bdureau/MotorTestStand/board images/teststand board.jpg

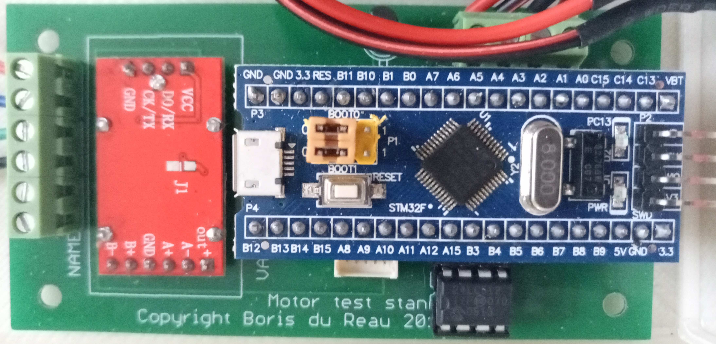
board images/teststand board.jpg
