bdureau/MotorTestStand/(commit log)

2021-06-03 fixes to the data logging
    [MotorTestStand.ino, config.cpp, config.h]
2021-06-11 Fixes to the status and connection
    [MotorTestStand.ino, config.cpp]
2021-12-25 Added casing pressure measurement
2022-01-17 Fixes to the pressure
    [MotorTestStand.ino, config.cpp, config.h]
2022-01-25 Fixes to the config
    [MotorTestStand.ino, config.cpp, config.h]
2022-03-24 Various fixes to the firmware
    [MotorTestStand.ino, config.cpp, config.h, kalman.cpp, kalman.h, logger_i2c_eeprom.cpp]
2022-08-19 Fixed memory writing issues on some eeprom
    [IC2extEEPROM.cpp, MotorTestStand.ino, config.h, logger_i2c_eeprom.cpp, logger_i2c_eeprom.h]
